TheoLephay/pondMonitor/hardware/pond_pcb_design_sheet.pdf

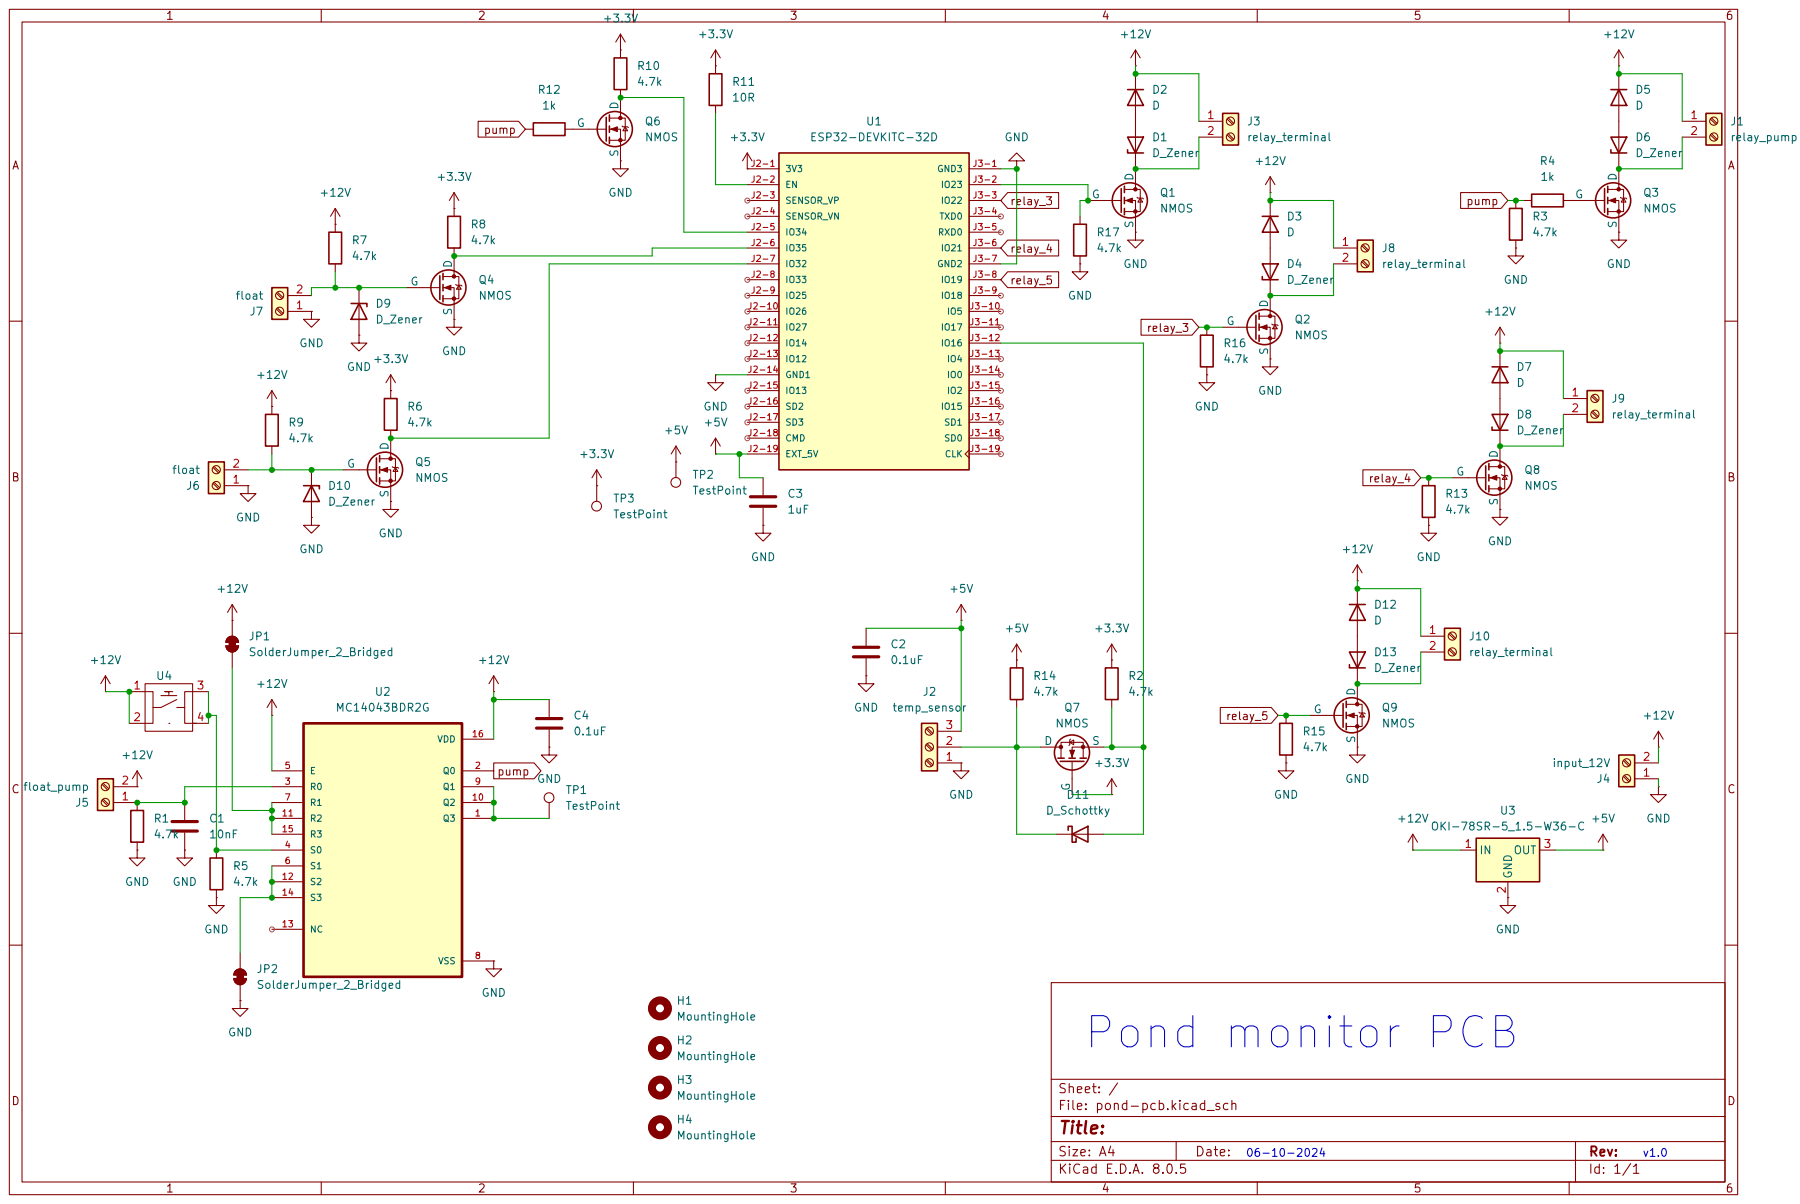
[picture p2: page 1]
