TheoLephay/pondMonitor/sketch_apr25a/ui.cpp

/// Copyright (c) 2025 Theo Lephay - All Right Reserved

#include <Arduino.h>
#include "portmacro.h"
#include "ui.hpp"
#include "data_manager.h"
#include <ESPAsyncWebServer.h>
#include <ESPDash.h>
#include "board_hal.h"
#include "WString.h"
#include "credentials.h"


int chartAxisX[MAX(HOURLY_TEMP_ARRAY_SZ, DAYS_PER_MONTH)] = { 0 };
const char *statusString = NULL;

// Unfortunately server init has to stay here to be before dashboard
AsyncWebServer server(80);
ESPDash dashboard(&server);

Card temperature(&dashboard, TEMPERATURE_CARD, "Temperature", "°C");

Card R2Button(&dashboard, BUTTON_CARD, "R2 - DRUM");
Card R3Button(&dashboard, BUTTON_CARD, "R3 - LIGHTS");
Card R4Button(&dashboard, BUTTON_CARD, "R4");
Card R5Button(&dashboard, BUTTON_CARD, "R5");
Card ClrButton(&dashboard, BUTTON_CARD, "Clear error");

Card pumpInfo(&dashboard, STATUS_CARD, "Pump status", DASH_STATUS_SUCCESS);
Card float1Info(&dashboard, STATUS_CARD, "Float 1 status", DASH_STATUS_SUCCESS);
Card float2Info(&dashboard, STATUS_CARD, "switch status", DASH_STATUS_SUCCESS);

Chart hourlyTempChart(&dashboard, BAR_CHART, "hourly temperatures");

Chart dailyDrumChart(&dashboard, BAR_CHART, "daily drum activations");

Card softwareInfo(&dashboard, STATUS_CARD, "software status", DASH_STATUS_IDLE);

Statistic upTimeStatistic(&dashboard, "uptime", "0d0h0s");

void updateUptime(void* pData);
esp_timer_handle_t uptimeTimerHandle = { 0 };
esp_timer_create_args_t uptimeTimerData = {
  .callback = updateUptime,
  .arg = NULL,
  .name = "uptimeTimer",
  .skip_unhandled_events = true,
};

TaskHandle_t UiTaskHandle;

void updateUptime(void* pData)
{
    static char buff[15u];
    String uptime = DataMgr_getUptimeStr();

    for (uint8_t i = 0; i < uptime.length() + 1; i++) {
        buff[i] = uptime.c_str()[i];
    }

    upTimeStatistic.set((const char*) buff);
}

void updateDrum(void)
{
    int *dataY = DataMgr_GetDrumActToDisplay();
    dailyDrumChart.updateY(dataY, DAYS_PER_MONTH);
}

void updateTemp(void)
{
    float *hourlyTempsY = DataMgr_getTempsToDisplay(HOURLY_TEMP_ARRAY_SZ);

    hourlyTempChart.updateY(hourlyTempsY, HOURLY_TEMP_ARRAY_SZ);
    temperature.update(hourlyTempsY[0]);
}

void displayError(const char *str)
{
    statusString = str;
    xTaskNotify(UiTaskHandle, DISPLAY_ERROR_MSK, eSetValueWithOverwrite);
}

void R2ButtonCb(int value)
{
    if(value)
    {
        xTaskNotify(UiTaskHandle, R2_BUTTON_ON_MSK, eSetBits);
        xTaskNotify(boardTaskHandle, DRUM_START_MSK, eSetBits);
    }
}

void R3ButtonCb(int value)
{
    if(value)
    {
        xTaskNotify(UiTaskHandle, R3_BUTTON_ON_MSK, eSetBits);
        xTaskNotify(boardTaskHandle, R3_CLOSE_MSK, eSetBits);
    }
    else
    {
        xTaskNotify(UiTaskHandle, R3_BUTTON_OFF_MSK, eSetBits);
        xTaskNotify(boardTaskHandle, R3_OPEN_MSK, eSetBits);
    }
}

void R4ButtonCb(int value)
{
    if(value)
    {
        xTaskNotify(UiTaskHandle, R4_BUTTON_ON_MSK, eSetBits);
        xTaskNotify(boardTaskHandle, R4_CLOSE_MSK, eSetBits);
    }
    else
    {
        xTaskNotify(UiTaskHandle, R4_BUTTON_OFF_MSK, eSetBits);
        xTaskNotify(boardTaskHandle, R4_OPEN_MSK, eSetBits);
    }
}

void R5ButtonCb(int value)
{
    if(value)
    {
        xTaskNotify(UiTaskHandle, R5_BUTTON_ON_MSK, eSetBits);
        xTaskNotify(boardTaskHandle, R5_CLOSE_MSK, eSetBits);
    }
    else
    {
        xTaskNotify(UiTaskHandle, R5_BUTTON_OFF_MSK, eSetBits);
        xTaskNotify(boardTaskHandle, R5_OPEN_MSK, eSetBits);
    }
}

void ClrErrorButtonCb(int value)
{
    statusString = "All good";
    xTaskNotify(UiTaskHandle, CLR_ERROR_MSK, eSetBits);
}


void UI_setup(void)
{
    dashboard.setAuthentication(web_id, web_password);

    for(uint16_t i = 0; i < ARRAY_SZ(chartAxisX); i++)
    {
        chartAxisX[i] = -i;
    }
    hourlyTempChart.updateX(chartAxisX, HOURLY_TEMP_ARRAY_SZ);
    dailyDrumChart.updateX(chartAxisX, DAYS_PER_MONTH);

    float *hourlyTempsY = DataMgr_getTempsToDisplay(HOURLY_TEMP_ARRAY_SZ);
    hourlyTempChart.updateY(hourlyTempsY, HOURLY_TEMP_ARRAY_SZ);

    int *dataY = DataMgr_GetDrumActToDisplay();
    dailyDrumChart.updateY(dataY, DAYS_PER_MONTH);

    R2Button.attachCallback(R2ButtonCb);
    R3Button.attachCallback(R3ButtonCb);
    R4Button.attachCallback(R4ButtonCb);
    R5Button.attachCallback(R5ButtonCb);
    ClrButton.attachCallback(ClrErrorButtonCb);

    esp_timer_create(&uptimeTimerData, &uptimeTimerHandle);
    esp_timer_start_periodic(uptimeTimerHandle, UPTIME_TIMER_PERIOD_US);
    updateUptime(NULL);

    softwareInfo.update("UI initialized", DASH_STATUS_SUCCESS);
    dashboard.sendUpdates();
}

void UiTask(void *arg)
{
    uint32_t notificationFlags;
    while(1)
    {
        BaseType_t notifReceived = xTaskNotifyWait(0x0u, 0xFFFFFFFFu, &notificationFlags, pdMS_TO_TICKS(portMAX_DELAY));

        if (notifReceived == pdFAIL) continue;

        if ((notificationFlags & UPDATE_TEMP_MSK) != 0u)
        {
            updateTemp();
        }

        if ((notificationFlags & UPDATE_DRUM_MSK) != 0u)
        {
            updateDrum();
        }

        if ((notificationFlags & DISPLAY_ERROR_MSK) != 0u)
        {
            if(statusString != NULL)
            {
                softwareInfo.update(statusString, DASH_STATUS_DANGER);
            }
            else
            {
                softwareInfo.update("Error", DASH_STATUS_DANGER);
            }
        }
        if((notificationFlags & CLR_ERROR_MSK) != 0u)
        {
            softwareInfo.update(statusString, DASH_STATUS_SUCCESS);
        }

        if ((notificationFlags & (R2_BUTTON_ON_MSK | R2_BUTTON_OFF_MSK)) != 0u)
        {
            R2Button.update((notificationFlags & R2_BUTTON_ON_MSK) != 0u);
        }

        if ((notificationFlags & (R3_BUTTON_ON_MSK | R3_BUTTON_OFF_MSK)) != 0u)
        {
            R3Button.update((notificationFlags & R3_BUTTON_ON_MSK) != 0u);
        }

        if ((notificationFlags & (R4_BUTTON_ON_MSK | R4_BUTTON_OFF_MSK)) != 0u)
        {
            R4Button.update((notificationFlags & R4_BUTTON_ON_MSK) != 0u);
        }

        if ((notificationFlags & (R5_BUTTON_ON_MSK | R5_BUTTON_OFF_MSK)) != 0u)
        {
            R5Button.update((notificationFlags & R5_BUTTON_ON_MSK) != 0u);
        }

        if ((notificationFlags & FLOAT1_INFO_CLOSED_MSK) != 0u)
        {
            float1Info.update("Closed", DASH_STATUS_DANGER);
        }
        if ((notificationFlags & FLOAT1_INFO_OPEN_MSK) != 0u)
        {
            float1Info.update("Open", DASH_STATUS_SUCCESS);
        }

        if ((notificationFlags & FLOAT2_INFO_CLOSED_MSK) != 0u)
        {
            float2Info.update("Closed", DASH_STATUS_DANGER);
        }
        if ((notificationFlags & FLOAT2_INFO_OPEN_MSK) != 0u)
        {
            float2Info.update("Open", DASH_STATUS_SUCCESS);
        }

        if ((notificationFlags & PUMP_INFO_CLOSED_MSK) != 0u)
        {
            pumpInfo.update("Stopped", DASH_STATUS_DANGER);
        }
        if ((notificationFlags & PUMP_INFO_OPEN_MSK) != 0u)
        {
            pumpInfo.update("Working", DASH_STATUS_SUCCESS);
        }

        dashboard.sendUpdates();
    }
}
