TheoLephay/pondMonitor/(commit log)

2025-08-16 Replace DHT by DS18B20
    [DS18B20.c, DS18B20.h, board_hal.cpp]
2025-08-16 pump status implementation
2025-08-16 fix relay 4 control & minor improvements
    [board_hal.cpp, sketch_apr25a.ino, ui.cpp]
